baertluka/Linefollower/readme.md

# LineFollower

Foto

## specifications

microcontroller: Arduino Nano

motors: micro metal gear motoren van Pololu 600 rpm

h-bridge: DRV8833

sensors: QTR-8a

batteries: 2 x 18650 batterijen (samen = 7,2 V)

wireless communication: HC-05

distance sensor - motors: 

weight: 

speed: 0,58 m/s
