baertluka/Linefollower/gebruiksaanwijzing/Handleiding.pdf

# Handleiding Line follower

Naam: Baert
Voornaam: Luka

## Gebruik van de line follower

Voor de line follower te laten rijden moeten eerst alle parameters worden ingesteld en moeten de sensoren worden gekalibreerd.
Kalibreren

Vooraleer de line follower kan rijden, moeten de sensoren gekalibreerd worden. Dit gebeurt via de seriële monitor op de computer of via een bluetoothmodule. Typ hiervoor het commando “calibrate white” of “calibrate black”. Let erop dat de robot zich bij “calibrate white” volledig op een witte ondergrond bevindt, en bij

“calibrate black” volledig op een zwarte ondergrond. Zodra het commando is verzonden, worden de waarden automatisch opgeslagen.

Rijden
Na de kalibratie kunnen de parameters worden ingesteld en kan de robot rijden. Met het commando “run” start de line follower met rijden. Met “stop” stopt deze onmiddellijk.
Wanneer een foutief of onbekend commando wordt ingevoerd, verschijnt een melding dat het commando niet herkend werd. Er kan dus niets misgaan wanneer een verkeerd commando wordt doorgestuurd.

De commando’s

Run | Starten met rijden (dit kan ook met de knop gedaan worden)
Stop | Stoppen met rijden
Debug | Tonen van de ingestelde parameters met de waarden
Calibrate | Calibreren van de sensoren (black of white)
set cycle ‘waarde’ | Set cycle naar‘waarde’ (waarde moet cijferzijn)
set power ‘waarde’ | Set power naar ‘waarde’ (waarde moet cijfer zijn)
set diff ‘waarde’ | Set diff naar ‘waarde’ (waarde moet cijfer zijn)
set kp ‘waarde’ | Set kp naar ‘waarde’ (waarde moet cijferzijn)
set ki ‘waarde’ | Set ki naar‘waarde’ (waarde moet cijferzijn)
set kd ‘waarde’ | Set kd naar ‘waarde’ (waarde moet cijferzijn)

De ingestelde waarden

Cycle | 500
Power | 85
Diff | 0.5
Kp | 12
Ki | 0.1
Kd | 0.1
