baertluka/Linefollower/technische tekeningen/mechanisch/Tremendous Jaban (1).png

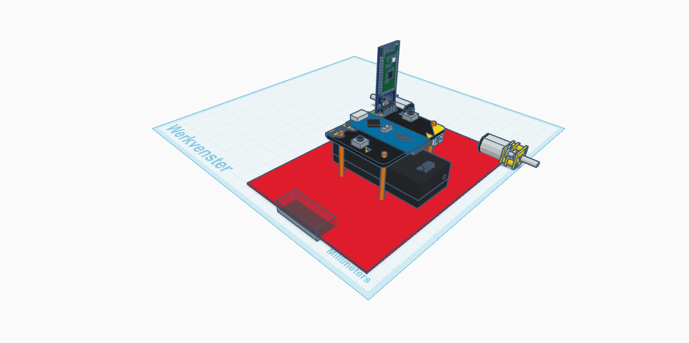
technische tekeningen/mechanisch/Tremendous Jaban (1).png
