baertluka/Linefollower/bill of materials/readme.md

## Bill of Materials  
|volgnummer|naam|omschrijving|nieuw/recup|kostprijs/stuk|aantal|subtotaal|  
|---|----|---|---|---|---|---|
| 1 | Chassis | Dit is de romp van de auto. | nieuw | € 3,69 | 1 | € 3,69 |  
| 2 | DuPont Jumper draad Female-Female 20cm 10 draden | Kabels om sensor met printplaat te verbinden. | nieuw | € 2,50 | 2 | € 5,00 |  
| 3 | Bluetooth module | Type: HC-05 | recup | € 14,90 | 1 | € 14,90 |  
| 4 | Arduino Nano | ATmega328 Nano | recup | € 17,96 | 1 | € 17,96 |  
| 5 | DRV8833 | Bipolaire Stappenmotor- en DC-Motoraansturing 001080 | nieuw | € 2,48 | 1 | € 2,48 |  
| 6 | Batterij | BAK 18650 Li-ion Batterij - 2900mAh - 8.25A - N18650CL-29 | recup | € 2,69 | 2 | € 5,37 |  
| 7 | 2 x 18650 Batterijhouder | Met losse draden - Button Top 004662 | nieuw | € 1,24 | 1 | € 1,24 |  
| 8 | 20 Pins header Female | 001128 | nieuw | € 0,30 | 20 | € 5,95 |  
| 9 | 2 Pin Schroef Terminal Block Connector 2.54mm Afstand | 000889 | nieuw | € 0,25 | 1 | € 0,25 |  
|10 | 4 Pin Schroef Terminal Block Connector 2.54mm Afstand | 001249 | nieuw | € 0,37 | 1 | € 0,37 |  
|11 | Micro Metal Gearmotor HP 6V | 2 x #2213 met verlengde motoras | nieuw | € 4,95 | 2 | € 9.90 |  
|12 | wiel, 32×7 mm | 2 x #1087 paar - Zwart | nieuw | € 2,45 | 1 | € 2,45 |  
|13 |  Micro Metal Gearmotor Bracket Extended Pair | 1 x #1089 | nieuw | € 2,95 | 1 | € 2.95 |  
|14 | QTR-8A reflectiesensorarray | 1 x #960 | nieuw | € 6,95 | 1 | € 6,95 | 
|15|  Knop  | De startknop | recup | € 0,1 | 1 |  € 0,1 |
|16|  5 mm led  | De led die weer geeft of de auto aan- of uit staat  | recup |  € 0,1 |  1 | € 0,1 |
|17|  Weerstand 220 Ω  | De weerstand voor de led | recup | € 0,05 | 1 | € 0,05 |
|18|  Weerstand 10 kΩ  |  Pull-down weerstand voor de startknop.  | recup | € 0,05 | 1 | € 0,05 |
|19|  15 Pins header Female  | / | nieuw | € 0,31	 | 2  | € 0,62 |
|20|  PCB  | / | nieuw | € 4,00	 | 1  | € 4 |
| | | | | | Totaal | € 86.48 |
