baertluka/Linefollower/code/proof of concepts/wireless communication/Line Following Robot - Wireless_communication.pdf

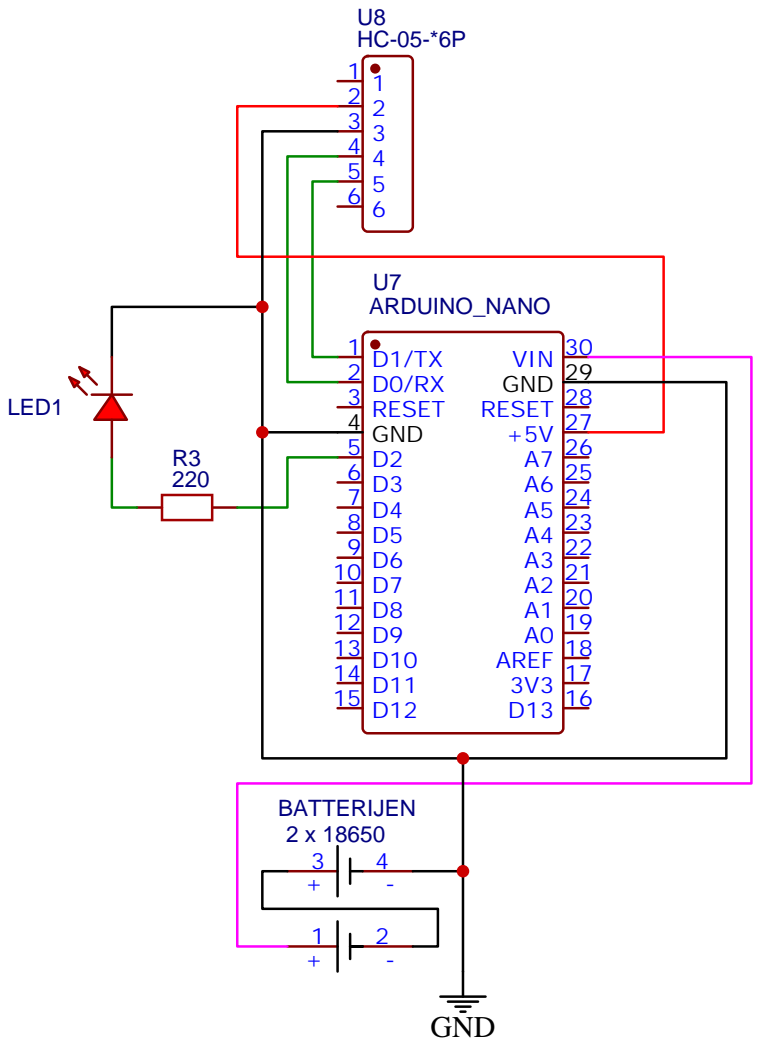
[picture p3: page 1]

Drawn By: Luka Baert
