baertluka/Linefollower/code/proof of concepts/interrupt/Line Following Robot - Interrupt.pdf

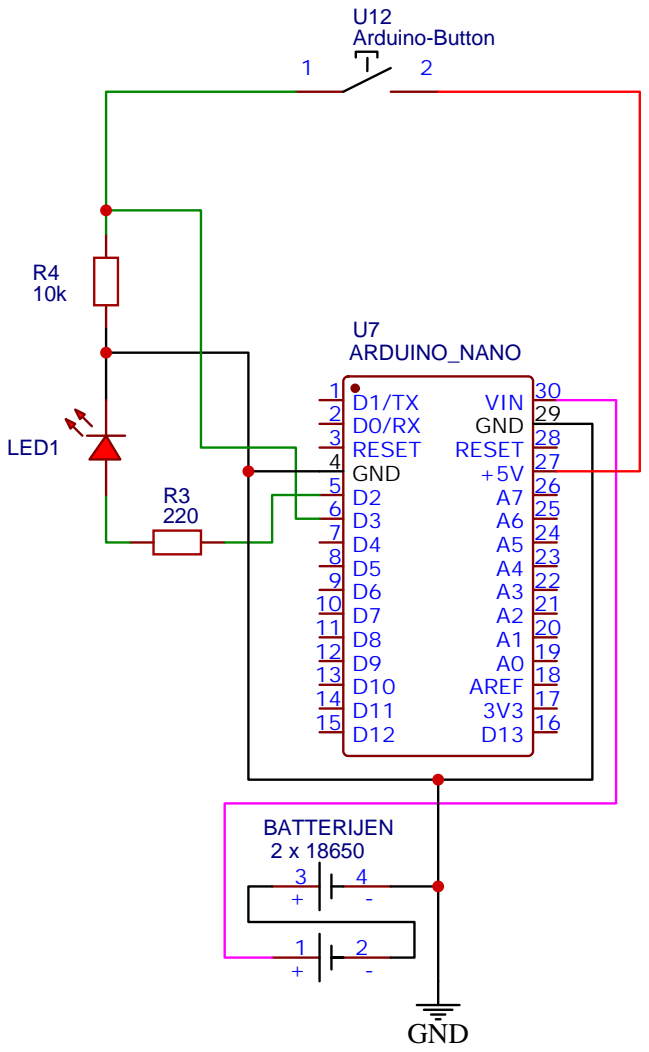
[picture p4: page 1]

Drawn By: Luka Baert
