baertluka/Linefollower/code/proof of concepts/sensor/Line Following Robot - Sensor.pdf

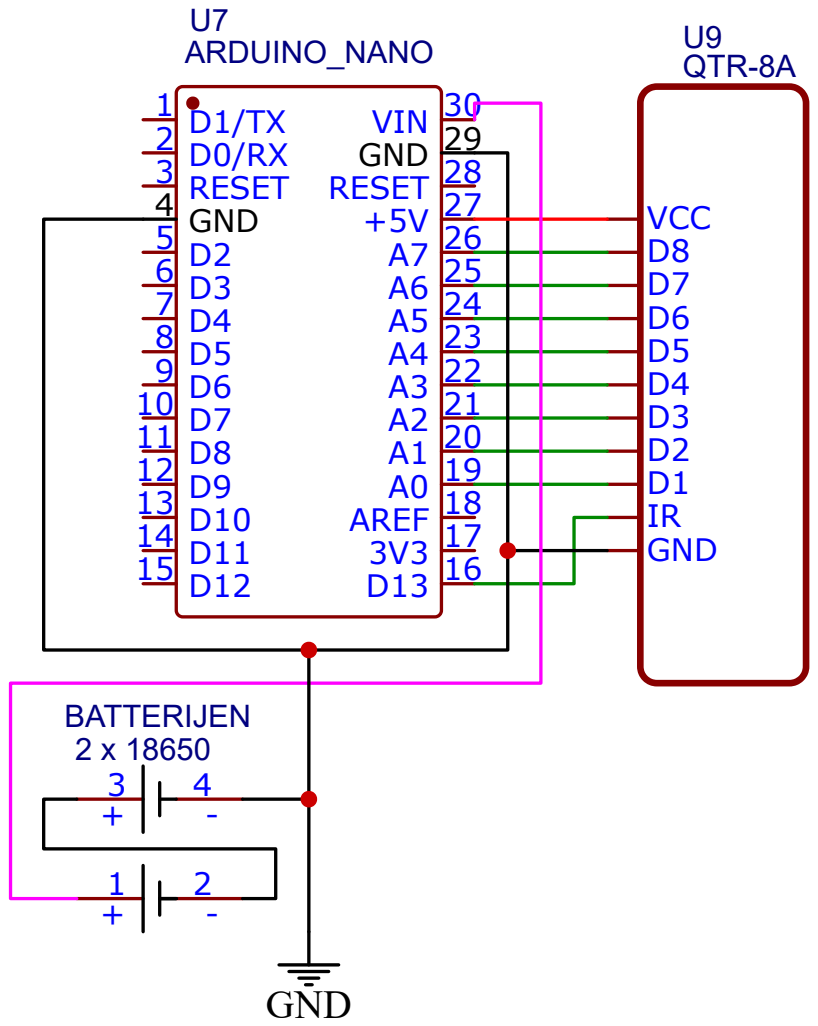
[picture p5: page 1]

Drawn By: Luka Baert
