baertluka/Linefollower/code/proof of concepts/hbridge/Line Following Robot - Hbrug.pdf

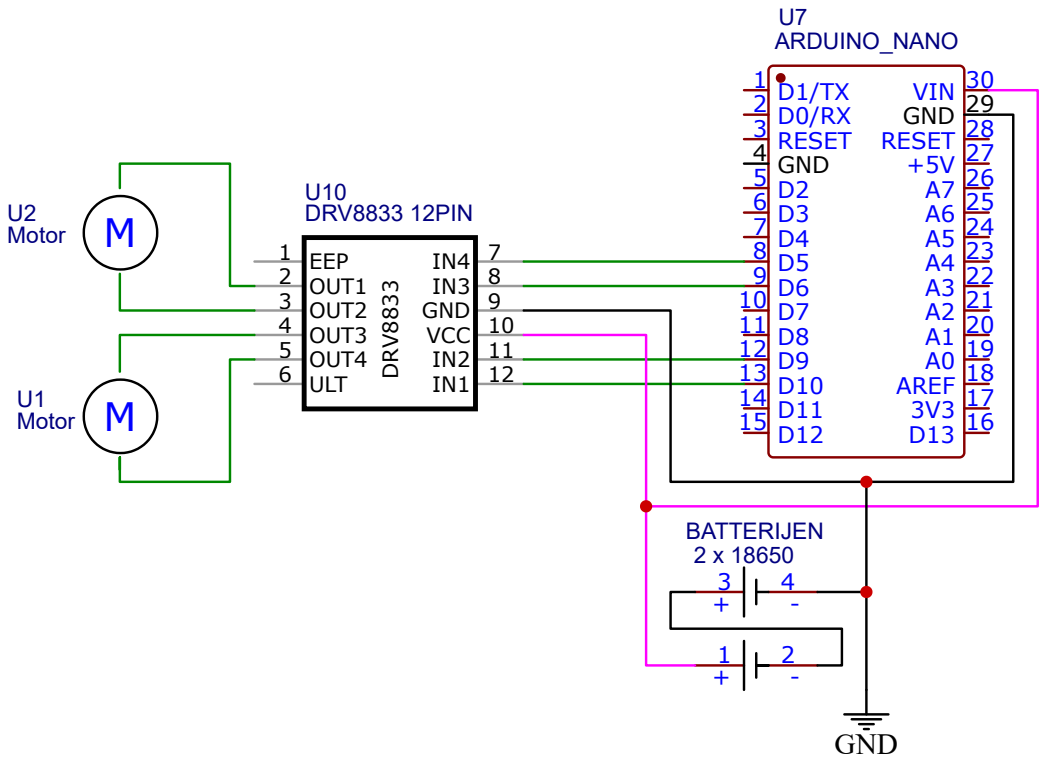
[picture p6: page 1]

Drawn By: Luka Baert
