baertluka/Linefollower/technische tekeningen/elektronisch/Elektrisch schema Line Following Robot-PlanA.pdf

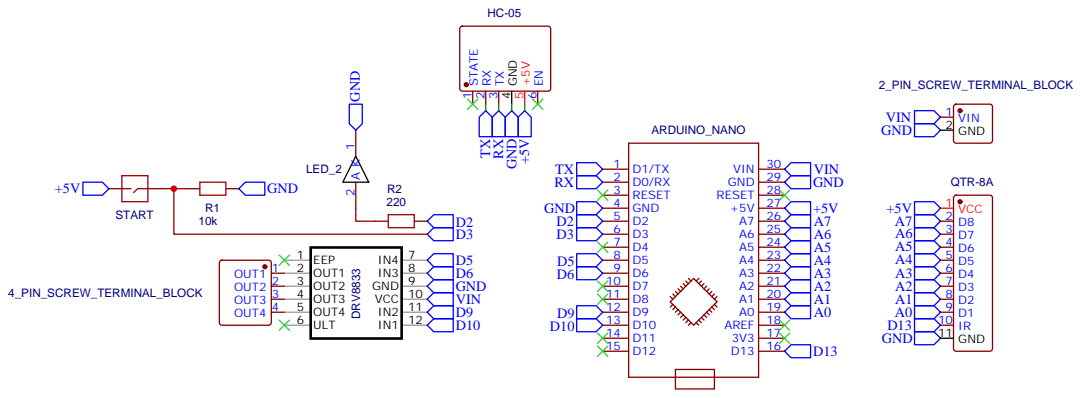
[picture p7: page 1]

Drawn By: Luka Baert
