baertluka/Linefollower/technische tekeningen/elektronisch/Elektrisch schema Line Following Robot.pdf

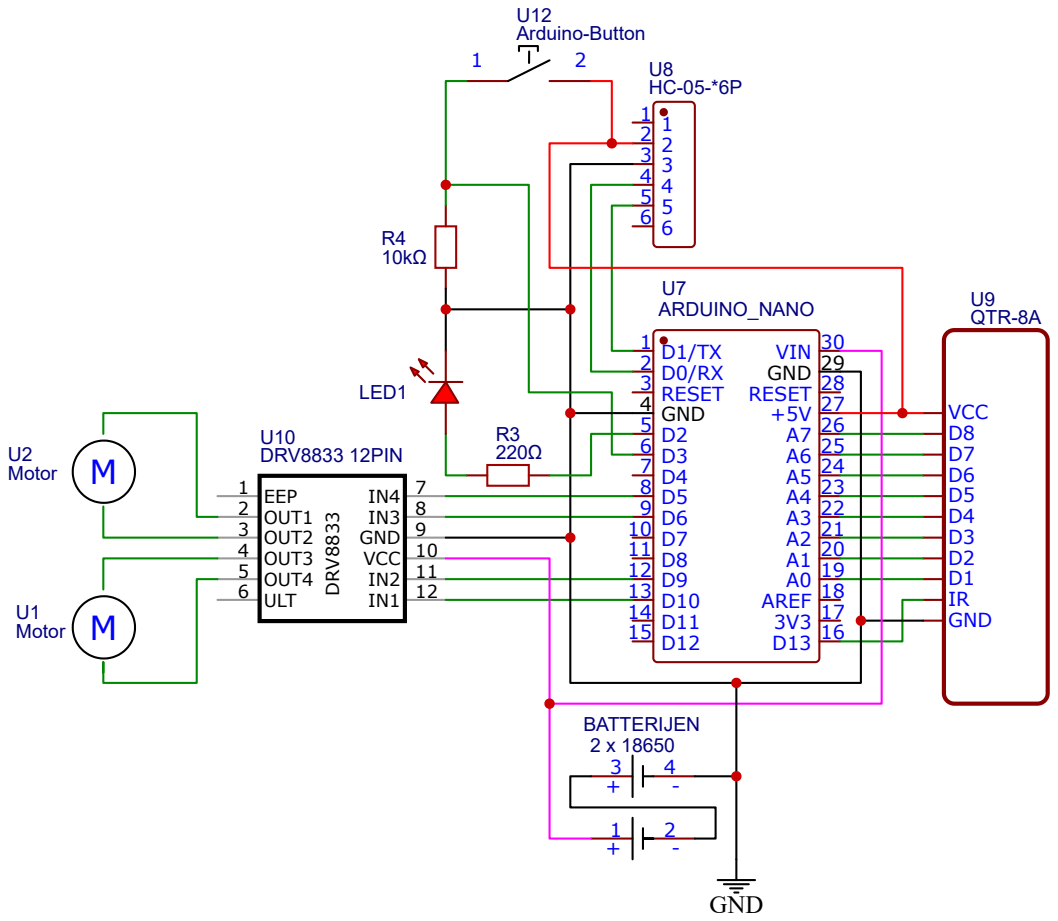
[picture p8: page 1]

Drawn By: Luka Baert
