baertluka/Linefollower/(list of files, drawings)

Other design files:
technische tekeningen/elektronisch/easyeda_linefollower_planA.json
technische tekeningen/elektronisch/easyeda_linefollower_planB.json
