baertluka/Linefollower/instructable/readme.md

# Instructable

## Stap 1 — Componenten

Bestel alle componenten uit de bill of materials.

## Stap 2 — Componenten Testen

Test alle componenten met proof-of-concept bekabeling voordat je ze integreert in het systeem.

## Stap 3 — Mechanische Opbouw

Monteer het robotframe volgens de technische tekeningen.

## Stap 4 — Elektronica Installeren

Plaats de microcontroller en bevestig alle elektronische componenten zoals aangeduid in het schema.

## Stap 5 — PCB Installatie

Aangezien er een PCB werd ontworpen, is bekabeling niet nodig. Monteer en verbind alle componenten via de PCB zoals voorzien.
Verbind alle componenten volgens het elektrisch schema in de technische tekeningen.

## Stap 6 — Firmware Compileren

Compileer de microcontroller-code in de IDE zoals vermeld in de projectdocumentatie.

## Stap 7 — Upload

Upload de firmware naar de microcontroller en voer een functionele test uit.

## Stap 8 - Tuning

Om de line-follower sneller het parcours te laten afleggen is tuning nodig van de PID regeling.
